christianscarlett/mazernnr/FP.cydsn/codegentemp/ADC_SAR_1.c

/*******************************************************************************
* File Name: ADC_SAR_1.c
* Version 3.0
*
* Description:
*  This file provides the source code to the API for the Successive
*  approximation ADC Component.
*
* Note:
*
********************************************************************************
* Copyright 2008-2015, Cypress Semiconductor Corporation.  All rights reserved.
* You may use this file only in accordance with the license, terms, conditions,
* disclaimers, and limitations in the end user license agreement accompanying
* the software package with which this file was provided.
*******************************************************************************/

#include "CyLib.h"
#include "ADC_SAR_1.h"

#if(ADC_SAR_1_DEFAULT_INTERNAL_CLK)
    #include "ADC_SAR_1_theACLK.h"
#endif /* End ADC_SAR_1_DEFAULT_INTERNAL_CLK */


/***************************************
* Forward function references
***************************************/
static void ADC_SAR_1_CalcGain(uint8 resolution);


/***************************************
* Global data allocation
***************************************/
uint8 ADC_SAR_1_initVar = 0u;
volatile int16 ADC_SAR_1_offset;
volatile int16 ADC_SAR_1_countsPerVolt;     /* Obsolete Gain compensation */
volatile int32 ADC_SAR_1_countsPer10Volt;   /* Gain compensation */
volatile int16 ADC_SAR_1_shift;


/*******************************************************************************
* Function Name: ADC_SAR_1_Start
********************************************************************************
*
* Summary:
*  This is the preferred method to begin component operation.
*  ADC_SAR_1_Start() sets the initVar variable, calls the
*  ADC_SAR_1_Init() function, and then calls the
*  ADC_SAR_1_Enable() function.
*
* Parameters:
*  None.
*
* Return:
*  None.
*
* Global variables:
*  The ADC_SAR_1_initVar variable is used to indicate when/if initial
*  configuration of this component has happened. The variable is initialized to
*  zero and set to 1 the first time ADC_Start() is called. This allows for
*  component Re-Start without re-initialization in all subsequent calls to the
*  ADC_SAR_1_Start() routine.
*  If re-initialization of the component is required the variable should be set
*  to zero before call of ADC_SAR_1_Start() routine, or the user may call
*  ADC_SAR_1_Init() and ADC_SAR_1_Enable() as done in the
*  ADC_SAR_1_Start() routine.
*
* Side Effect:
*  If the initVar variable is already set, this function only calls the
*  ADC_SAR_1_Enable() function.
*
*******************************************************************************/
void ADC_SAR_1_Start(void)
{

    /* If not Initialized then initialize all required hardware and software */
    if(ADC_SAR_1_initVar == 0u)
    {
        ADC_SAR_1_Init();
        ADC_SAR_1_initVar = 1u;
    }
    ADC_SAR_1_Enable();
}


/*******************************************************************************
* Function Name: ADC_SAR_1_Init
********************************************************************************
*
* Summary:
*  Initialize component's parameters to the parameters set by user in the
*  customizer of the component placed onto schematic. Usually called in
*  ADC_SAR_1_Start().
*
* Parameters:
*  None.
*
* Return:
*  None.
*
* Global variables:
*  The ADC_SAR_1_offset variable is initialized to 0.
*
*******************************************************************************/
void ADC_SAR_1_Init(void)
{

    /* This is only valid if there is an internal clock */
    #if(ADC_SAR_1_DEFAULT_INTERNAL_CLK)
        ADC_SAR_1_theACLK_SetMode(CYCLK_DUTY);
    #endif /* End ADC_SAR_1_DEFAULT_INTERNAL_CLK */

    #if(ADC_SAR_1_IRQ_REMOVE == 0u)
        /* Start and set interrupt vector */
        CyIntSetPriority(ADC_SAR_1_INTC_NUMBER, ADC_SAR_1_INTC_PRIOR_NUMBER);
        (void)CyIntSetVector(ADC_SAR_1_INTC_NUMBER, &ADC_SAR_1_ISR);
    #endif   /* End ADC_SAR_1_IRQ_REMOVE */

    /* Enable IRQ mode*/
    ADC_SAR_1_SAR_CSR1_REG |= ADC_SAR_1_SAR_IRQ_MASK_EN | ADC_SAR_1_SAR_IRQ_MODE_EDGE;

    /*Set SAR ADC resolution ADC */
    ADC_SAR_1_SetResolution(ADC_SAR_1_DEFAULT_RESOLUTION);
    ADC_SAR_1_offset = 0;
}


/*******************************************************************************
* Function Name: ADC_SAR_1_Enable
********************************************************************************
*
* Summary:
*  Enables the reference, clock and power for SAR ADC.
*
* Parameters:
*  None.
*
* Return:
*  None.
*
*******************************************************************************/
void ADC_SAR_1_Enable(void)
{
    uint8 tmpReg;
    uint8 enableInterrupts;
    enableInterrupts = CyEnterCriticalSection();

    /* Enable the SAR ADC block in Active Power Mode */
    ADC_SAR_1_PWRMGR_SAR_REG |= ADC_SAR_1_ACT_PWR_SAR_EN;

     /* Enable the SAR ADC in Standby Power Mode*/
    ADC_SAR_1_STBY_PWRMGR_SAR_REG |= ADC_SAR_1_STBY_PWR_SAR_EN;

    /* This is only valid if there is an internal clock */
    #if(ADC_SAR_1_DEFAULT_INTERNAL_CLK)
        ADC_SAR_1_PWRMGR_CLK_REG |= ADC_SAR_1_ACT_PWR_CLK_EN;
        ADC_SAR_1_STBY_PWRMGR_CLK_REG |= ADC_SAR_1_STBY_PWR_CLK_EN;
    #endif /* End ADC_SAR_1_DEFAULT_INTERNAL_CLK */

    /* Enable VCM buffer and Enable Int Ref Amp */
    tmpReg = ADC_SAR_1_SAR_CSR3_REG;
    tmpReg |= ADC_SAR_1_SAR_EN_BUF_VCM_EN;
    /* PD_BUF_VREF is OFF in External reference or Vdda reference mode */
    #if((ADC_SAR_1_DEFAULT_REFERENCE == ADC_SAR_1__EXT_REF) || \
        (ADC_SAR_1_DEFAULT_RANGE == ADC_SAR_1__VNEG_VDDA_DIFF))
        tmpReg &= (uint8)~ADC_SAR_1_SAR_EN_BUF_VREF_EN;
    #else /* In INTREF or INTREF Bypassed this buffer is ON */
        tmpReg |= ADC_SAR_1_SAR_EN_BUF_VREF_EN;
    #endif /* ADC_SAR_1_DEFAULT_REFERENCE == ADC_SAR_1__EXT_REF */
    ADC_SAR_1_SAR_CSR3_REG = tmpReg;

    /* Set reference for ADC */
    #if(ADC_SAR_1_DEFAULT_RANGE == ADC_SAR_1__VNEG_VDDA_DIFF)
        #if(ADC_SAR_1_DEFAULT_REFERENCE == ADC_SAR_1__EXT_REF)
            ADC_SAR_1_SAR_CSR6_REG = ADC_SAR_1_INT_BYPASS_EXT_VREF; /* S2 */
        #else /* Internal Vdda reference or obsolete bypass mode */
            ADC_SAR_1_SAR_CSR6_REG = ADC_SAR_1_VDDA_VREF;           /* S7 */
        #endif /* ADC_SAR_1_DEFAULT_REFERENCE == ADC_SAR_1__EXT_REF */
    #else  /* Reference goes through internal buffer */
        #if(ADC_SAR_1_DEFAULT_REFERENCE == ADC_SAR_1__INT_REF_NOT_BYPASSED)
            ADC_SAR_1_SAR_CSR6_REG = ADC_SAR_1_INT_VREF;            /* S3 + S4 */
        #else /* INTREF Bypassed of External */
            ADC_SAR_1_SAR_CSR6_REG = ADC_SAR_1_INT_BYPASS_EXT_VREF; /* S2 */
        #endif /* ADC_SAR_1_DEFAULT_REFERENCE == ADC_SAR_1__INT_REF_NOT_BYPASSED */
    #endif /* VNEG_VDDA_DIFF */

    /* Low non-overlap delay for sampling clock signals (for 1MSPS) */
    #if(ADC_SAR_1_HIGH_POWER_PULSE == 0u) /* MinPulseWidth <= 50 ns */
        ADC_SAR_1_SAR_CSR5_REG &= (uint8)~ADC_SAR_1_SAR_DLY_INC;
    #else /* Set High non-overlap delay for sampling clock signals (for <500KSPS)*/
        ADC_SAR_1_SAR_CSR5_REG |= ADC_SAR_1_SAR_DLY_INC;
    #endif /* ADC_SAR_1_HIGH_POWER_PULSE == 0u */

    /* Increase comparator latch enable delay by 20%, 
    *  Increase comparator bias current by 30% without impacting delaysDelay 
    *  Default for 1MSPS) 
    */
    #if(ADC_SAR_1_HIGH_POWER_PULSE == 0u)    /* MinPulseWidth <= 50 ns */
        ADC_SAR_1_SAR_CSR5_REG |= ADC_SAR_1_SAR_SEL_CSEL_DFT_CHAR;
    #else /* for <500ksps */
        ADC_SAR_1_SAR_CSR5_REG &= (uint8)~ADC_SAR_1_SAR_SEL_CSEL_DFT_CHAR;
    #endif /* ADC_SAR_1_HIGH_POWER_PULSE == 0u */

    /* Set default power and other configurations for control register 0 in multiple lines */
    ADC_SAR_1_SAR_CSR0_REG = (uint8)((uint8)ADC_SAR_1_DEFAULT_POWER << ADC_SAR_1_SAR_POWER_SHIFT)
    /* SAR_HIZ_CLEAR:   Should not be used for LP */
    #if ((CY_PSOC5LP) || (ADC_SAR_1_DEFAULT_REFERENCE != ADC_SAR_1__EXT_REF))
        | ADC_SAR_1_SAR_HIZ_CLEAR
    #endif /* SAR_HIZ_CLEAR */
    /*Set Convertion mode */
    #if(ADC_SAR_1_DEFAULT_CONV_MODE != ADC_SAR_1__FREE_RUNNING)      /* If triggered mode */
        | ADC_SAR_1_SAR_MX_SOF_UDB           /* source: UDB */
        | ADC_SAR_1_SAR_SOF_MODE_EDGE        /* Set edge-sensitive sof source */
    #endif /* ADC_SAR_1_DEFAULT_CONV_MODE */
    ; /* end of multiple line initialization */

    ADC_SAR_1_SAR_TR0_REG = ADC_SAR_1_SAR_CAP_TRIM_2;

    /* Enable clock for SAR ADC*/
    ADC_SAR_1_SAR_CLK_REG |= ADC_SAR_1_SAR_MX_CLK_EN;

    CyDelayUs(10u); /* The block is ready to use 10 us after the enable signal is set high. */

    #if(ADC_SAR_1_IRQ_REMOVE == 0u)
        /* Clear a pending interrupt */
        CyIntClearPending(ADC_SAR_1_INTC_NUMBER);
    #endif   /* End ADC_SAR_1_IRQ_REMOVE */

    CyExitCriticalSection(enableInterrupts);
}


/*******************************************************************************
* Function Name: ADC_SAR_1_Stop
********************************************************************************
*
* Summary:
*  Stops ADC conversions and puts the ADC into its lowest power mode.
*
* Parameters:
*  None.
*
* Return:
*  None.
*
*******************************************************************************/
void ADC_SAR_1_Stop(void)
{
    uint8 enableInterrupts;
    enableInterrupts = CyEnterCriticalSection();

    /* Stop all conversions */
    ADC_SAR_1_SAR_CSR0_REG &= (uint8)~ADC_SAR_1_SAR_SOF_START_CONV;
    /* Disable the SAR ADC block in Active Power Mode */
    ADC_SAR_1_PWRMGR_SAR_REG &= (uint8)~ADC_SAR_1_ACT_PWR_SAR_EN;
    /* Disable the SAR ADC in Standby Power Mode */
    ADC_SAR_1_STBY_PWRMGR_SAR_REG &= (uint8)~ADC_SAR_1_STBY_PWR_SAR_EN;

    /* This is only valid if there is an internal clock */
    #if(ADC_SAR_1_DEFAULT_INTERNAL_CLK)
        ADC_SAR_1_PWRMGR_CLK_REG &= (uint8)~ADC_SAR_1_ACT_PWR_CLK_EN;
        ADC_SAR_1_STBY_PWRMGR_CLK_REG &= (uint8)~ADC_SAR_1_STBY_PWR_CLK_EN;
    #endif /* End ADC_SAR_1_DEFAULT_INTERNAL_CLK */

    CyExitCriticalSection(enableInterrupts);

}


/*******************************************************************************
* Function Name: ADC_SAR_1_SetPower
********************************************************************************
*
* Summary:
*  Sets the operational power of the ADC. You should use the higher power
*  settings with faster clock speeds.
*
* Parameters:
*  power:  Power setting for ADC
*  0 ->    Normal
*  1 ->    Medium power
*  2 ->    1.25 power
*  3 ->    Minimum power.
*
* Return:
*  None.
*
*******************************************************************************/
void ADC_SAR_1_SetPower(uint8 power)
{
    uint8 tmpReg;

    /* mask off invalid power settings */
    power &= ADC_SAR_1_SAR_API_POWER_MASK;

    /* Set Power parameter  */
    tmpReg = ADC_SAR_1_SAR_CSR0_REG & (uint8)~ADC_SAR_1_SAR_POWER_MASK;
    tmpReg |= (uint8)(power << ADC_SAR_1_SAR_POWER_SHIFT);
    ADC_SAR_1_SAR_CSR0_REG = tmpReg;
}


/*******************************************************************************
* Function Name: ADC_SAR_1_SetResolution
********************************************************************************
*
* Summary:
*  Sets the Relution of the SAR.
*
* Parameters:
*  resolution:
*  12 ->    RES12
*  10 ->    RES10
*  8  ->    RES8
*
* Return:
*  None.
*
* Side Effects:
*  The ADC resolution cannot be changed during a conversion cycle. The
*  recommended best practice is to stop conversions with
*  ADC_StopConvert(), change the resolution, then restart the
*  conversions with ADC_StartConvert().
*  If you decide not to stop conversions before calling this API, you
*  should use ADC_IsEndConversion() to wait until conversion is complete
*  before changing the resolution.
*  If you call ADC_SetResolution() during a conversion, the resolution will
*  not be changed until the current conversion is complete. Data will not be
*  available in the new resolution for another 6 + "New Resolution(in bits)"
*  clock cycles.
*  You may need add a delay of this number of clock cycles after
*  ADC_SetResolution() is called before data is valid again.
*  Affects ADC_CountsTo_Volts(), ADC_CountsTo_mVolts(), and
*  ADC_CountsTo_uVolts() by calculating the correct conversion between ADC
*  counts and the applied input voltage. Calculation depends on resolution,
*  input range, and voltage reference.
*
*******************************************************************************/
void ADC_SAR_1_SetResolution(uint8 resolution)
{
    uint8 tmpReg;

    /* Set SAR ADC resolution and sample width: 18 conversion cycles at 12bits + 1 gap */
    switch (resolution)
    {
        case (uint8)ADC_SAR_1__BITS_12:
            tmpReg = ADC_SAR_1_SAR_RESOLUTION_12BIT | ADC_SAR_1_SAR_SAMPLE_WIDTH;
            break;
        case (uint8)ADC_SAR_1__BITS_10:
            tmpReg = ADC_SAR_1_SAR_RESOLUTION_10BIT | ADC_SAR_1_SAR_SAMPLE_WIDTH;
            break;
        case (uint8)ADC_SAR_1__BITS_8:
            tmpReg = ADC_SAR_1_SAR_RESOLUTION_8BIT | ADC_SAR_1_SAR_SAMPLE_WIDTH;
            break;
        default:
            tmpReg = ADC_SAR_1_SAR_RESOLUTION_12BIT | ADC_SAR_1_SAR_SAMPLE_WIDTH;
            /* Halt CPU in debug mode if resolution is out of valid range */
            CYASSERT(0u != 0u);
            break;
    }
    ADC_SAR_1_SAR_CSR2_REG = tmpReg;

     /* Calculate gain for convert counts to volts */
    ADC_SAR_1_CalcGain(resolution);
}


#if(ADC_SAR_1_DEFAULT_CONV_MODE != ADC_SAR_1__HARDWARE_TRIGGER)


    /*******************************************************************************
    * Function Name: ADC_SAR_1_StartConvert
    ********************************************************************************
    *
    * Summary:
    *  Forces the ADC to initiate a conversion. In free-running mode, the ADC runs
    *  continuously. In software trigger mode, the function also acts as a software
    *  version of the SOC and every conversion must be triggered by
    *  ADC_SAR_1_StartConvert(). This function is not available when the
    *  Hardware Trigger sample mode is selected.
    *
    * Parameters:
    *  None.
    *
    * Return:
    *  None.
    *
    * Theory:
    *  Forces the ADC to initiate a conversion. In Free Running mode, the ADC will
    *  run continuously. In a software trigger mode the function also acts as a
    *  software version of the SOC. Here every conversion has to be triggered by
    *  the routine. This writes into the SOC bit in SAR_CTRL reg.
    *
    * Side Effects:
    *  In a software trigger mode the function switches source for SOF from the
    *  external pin to the internal SOF generation. Application should not call
    *  StartConvert if external source used for SOF.
    *
    *******************************************************************************/
    void ADC_SAR_1_StartConvert(void)
    {
        #if(ADC_SAR_1_DEFAULT_CONV_MODE != ADC_SAR_1__FREE_RUNNING)  /* If software triggered mode */
            ADC_SAR_1_SAR_CSR0_REG &= (uint8)~ADC_SAR_1_SAR_MX_SOF_UDB;   /* source: SOF bit */
        #endif /* End ADC_SAR_1_DEFAULT_CONV_MODE */

        /* Start the conversion */
        ADC_SAR_1_SAR_CSR0_REG |= ADC_SAR_1_SAR_SOF_START_CONV;
    }


    /*******************************************************************************
    * Function Name: ADC_SAR_1_StopConvert
    ********************************************************************************
    *
    * Summary:
    *  Forces the ADC to stop conversions. If a conversion is currently executing,
    *  that conversion will complete, but no further conversions will occur. This
    *  function is not available when the Hardware Trigger sample mode is selected.
    *
    * Parameters:
    *  None.
    *
    * Return:
    *  None.
    *
    * Theory:
    *  Stops ADC conversion in Free Running mode.
    *
    * Side Effects:
    *  In Software Trigger sample mode, this function sets a software version of the
    *  SOC to low level and switches the SOC source to hardware SOC input.
    *
    *******************************************************************************/
    void ADC_SAR_1_StopConvert(void)
    {
        /* Stop all conversions */
        ADC_SAR_1_SAR_CSR0_REG &= (uint8)~ADC_SAR_1_SAR_SOF_START_CONV;

        #if(ADC_SAR_1_DEFAULT_CONV_MODE != ADC_SAR_1__FREE_RUNNING)  /* If software triggered mode */
            /* Return source to UDB for hardware SOF signal */
            ADC_SAR_1_SAR_CSR0_REG |= ADC_SAR_1_SAR_MX_SOF_UDB;    /* source: UDB */
        #endif /* End ADC_SAR_1_DEFAULT_CONV_MODE */

    }

#endif /* End ADC_SAR_1_DEFAULT_CONV_MODE != ADC_SAR_1__HARDWARE_TRIGGER */


/*******************************************************************************
* Function Name: ADC_SAR_1_IsEndConversion
********************************************************************************
*
* Summary:
*  Immediately returns the status of the conversion or does not return
*  (blocking) until the conversion completes, depending on the retMode
*  parameter.
*
* Parameters:
*  retMode:  Check conversion return mode.
*   ADC_SAR_1_RETURN_STATUS: Immediately returns the status. If the
*     value returned is zero, the conversion is not complete, and this function
*     should be retried until a nonzero result is returned.
*   ADC_SAR_1_WAIT_FOR_RESULT: Does not return a result until the ADC
*     conversion is complete.
*
* Return:
*  (uint8)  0 =>  The ADC is still calculating the last result.
*           1 =>  The last conversion is complete.
*
* Side Effects:
*  This function reads the end of conversion status, which is cleared on read.
*
*******************************************************************************/
uint8 ADC_SAR_1_IsEndConversion(uint8 retMode)
{
    uint8 status;

    do
    {
        status = ADC_SAR_1_SAR_CSR1_REG & ADC_SAR_1_SAR_EOF_1;
    } while ((status != ADC_SAR_1_SAR_EOF_1) && (retMode == ADC_SAR_1_WAIT_FOR_RESULT));
    /* If convertion complete, wait until EOF bit released */
    if(status == ADC_SAR_1_SAR_EOF_1)
    {
        /* wait one ADC clock to let the EOC status bit release */
        CyDelayUs(1u);
        /* Do the unconditional read operation of the CSR1 register to make sure the EOC bit has been cleared */
        CY_GET_REG8(ADC_SAR_1_SAR_CSR1_PTR);
    }

    return(status);
}


/*******************************************************************************
* Function Name: ADC_SAR_1_GetResult8
********************************************************************************
*
* Summary:
*  Returns the result of an 8-bit conversion. If the resolution is set greater
*  than 8 bits, the function returns the LSB of the result.
*  ADC_SAR_1_IsEndConversion() should be called to verify that the data
*   sample is ready.
*
* Parameters:
*  None.
*
* Return:
*  The LSB of the last ADC conversion.
*
* Global Variables:
*  ADC_SAR_1_shift - used to convert the ADC counts to the 2s
*  compliment form.
*
* Side Effects:
*  Converts the ADC counts to the 2s complement form.
*
*******************************************************************************/
int8 ADC_SAR_1_GetResult8( void )
{
    return( (int8)ADC_SAR_1_SAR_WRK0_REG - (int8)ADC_SAR_1_shift);
}


/*******************************************************************************
* Function Name: ADC_SAR_1_GetResult16
********************************************************************************
*
* Summary:
*  Returns a 16-bit result for a conversion with a result that has a resolution
*  of 8 to 12 bits.
*  ADC_SAR_1_IsEndConversion() should be called to verify that the data
*   sample is ready
*
* Parameters:
*  None.
*
* Return:
*  The 16-bit result of the last ADC conversion
*
* Global Variables:
*  ADC_SAR_1_shift - used to convert the ADC counts to the 2s
*  compliment form.
*
* Side Effects:
*  Converts the ADC counts to the 2s complement form.
*
*******************************************************************************/
int16 ADC_SAR_1_GetResult16( void )
{
    uint16 res;

    res = CY_GET_REG16(ADC_SAR_1_SAR_WRK_PTR);

    return( (int16)res - ADC_SAR_1_shift );
}


/*******************************************************************************
* Function Name: ADC_SAR_1_SetOffset
********************************************************************************
*
* Summary:
*  Sets the ADC offset, which is used by ADC_SAR_1_CountsTo_Volts(),
*  ADC_SAR_1_CountsTo_mVolts(), and ADC_SAR_1_CountsTo_uVolts()
*  to subtract the offset from the given reading before calculating the voltage
*  conversion.
*
* Parameters:
*  int16: This value is measured when the inputs are shorted or connected to
   the same input voltage.
*
* Return:
*  None.
*
* Global Variables:
*  The ADC_SAR_1_offset variable modified. This variable is used for
*  offset calibration purpose.
*  Affects the ADC_SAR_1_CountsTo_Volts,
*  ADC_SAR_1_CountsTo_mVolts, ADC_SAR_1_CountsTo_uVolts functions
*  by subtracting the given offset.
*
*******************************************************************************/
void ADC_SAR_1_SetOffset(int16 offset)
{
    ADC_SAR_1_offset = offset;
}


/*******************************************************************************
* Function Name: ADC_SAR_1_CalcGain
********************************************************************************
*
* Summary:
*  This function calculates the ADC gain in counts per 10 volt.
*
* Parameters:
*  uint8: resolution
*
* Return:
*  None.
*
* Global Variables:
*  ADC_SAR_1_shift variable initialized. This variable is used to
*  convert the ADC counts to the 2s compliment form.
*  ADC_SAR_1_countsPer10Volt variable initialized. This variable is used
*  for gain calibration purpose.
*
*******************************************************************************/
static void ADC_SAR_1_CalcGain( uint8 resolution )
{
    int32 counts;
    #if(!((ADC_SAR_1_DEFAULT_RANGE == ADC_SAR_1__VSS_TO_VREF) || \
         (ADC_SAR_1_DEFAULT_RANGE == ADC_SAR_1__VSSA_TO_VDDA) || \
         (ADC_SAR_1_DEFAULT_RANGE == ADC_SAR_1__VSSA_TO_VDAC)) )
        uint16 diff_zero;
    #endif /* End ADC_SAR_1_DEFAULT_RANGE */

    switch (resolution)
    {
        case (uint8)ADC_SAR_1__BITS_12:
            counts = (int32)ADC_SAR_1_SAR_WRK_MAX_12BIT;
            #if(!((ADC_SAR_1_DEFAULT_RANGE == ADC_SAR_1__VSS_TO_VREF) || \
                 (ADC_SAR_1_DEFAULT_RANGE == ADC_SAR_1__VSSA_TO_VDDA) || \
                 (ADC_SAR_1_DEFAULT_RANGE == ADC_SAR_1__VSSA_TO_VDAC)) )
                diff_zero = ADC_SAR_1_SAR_DIFF_SHIFT;
            #endif /* End ADC_SAR_1_DEFAULT_RANGE */
            break;
        case (uint8)ADC_SAR_1__BITS_10:
            counts = (int32)ADC_SAR_1_SAR_WRK_MAX_10BIT;
            #if(!((ADC_SAR_1_DEFAULT_RANGE == ADC_SAR_1__VSS_TO_VREF) || \
                 (ADC_SAR_1_DEFAULT_RANGE == ADC_SAR_1__VSSA_TO_VDDA) || \
                 (ADC_SAR_1_DEFAULT_RANGE == ADC_SAR_1__VSSA_TO_VDAC)) )
                diff_zero = ADC_SAR_1_SAR_DIFF_SHIFT >> 2u;
            #endif /* End ADC_SAR_1_DEFAULT_RANGE */
            break;
        case (uint8)ADC_SAR_1__BITS_8:
            counts = (int32)ADC_SAR_1_SAR_WRK_MAX_8BIT;
            #if(!((ADC_SAR_1_DEFAULT_RANGE == ADC_SAR_1__VSS_TO_VREF) || \
                 (ADC_SAR_1_DEFAULT_RANGE == ADC_SAR_1__VSSA_TO_VDDA) || \
                 (ADC_SAR_1_DEFAULT_RANGE == ADC_SAR_1__VSSA_TO_VDAC)) )
                diff_zero = ADC_SAR_1_SAR_DIFF_SHIFT >> 4u;
            #endif /* End ADC_SAR_1_DEFAULT_RANGE */
            break;
        default: /* Halt CPU in debug mode if resolution is out of valid range */
            counts = 0;
            #if(!((ADC_SAR_1_DEFAULT_RANGE == ADC_SAR_1__VSS_TO_VREF) || \
                 (ADC_SAR_1_DEFAULT_RANGE == ADC_SAR_1__VSSA_TO_VDDA) || \
                 (ADC_SAR_1_DEFAULT_RANGE == ADC_SAR_1__VSSA_TO_VDAC)) )
                diff_zero = 0u;
            #endif /* End ADC_SAR_1_DEFAULT_RANGE */
            CYASSERT(0u != 0u);
            break;
    }
    ADC_SAR_1_countsPerVolt = 0; /* Clear obsolete variable */
    /* Calculate gain in counts per 10 volts with rounding */
    ADC_SAR_1_countsPer10Volt = (((counts * ADC_SAR_1_10MV_COUNTS) +
                        ADC_SAR_1_DEFAULT_REF_VOLTAGE_MV) / (ADC_SAR_1_DEFAULT_REF_VOLTAGE_MV * 2));

    #if( (ADC_SAR_1_DEFAULT_RANGE == ADC_SAR_1__VSS_TO_VREF) || \
         (ADC_SAR_1_DEFAULT_RANGE == ADC_SAR_1__VSSA_TO_VDDA) || \
         (ADC_SAR_1_DEFAULT_RANGE == ADC_SAR_1__VSSA_TO_VDAC) )
        ADC_SAR_1_shift = 0;
    #else
        ADC_SAR_1_shift = diff_zero;
    #endif /* End ADC_SAR_1_DEFAULT_RANGE */
}


/*******************************************************************************
* Function Name: ADC_SAR_1_SetGain
********************************************************************************
*
* Summary:
*  Sets the ADC gain in counts per volt for the voltage conversion functions
*  that follow. This value is set by default by the reference and input range
*  settings. It should only be used to further calibrate the ADC with a known
*  input or if the ADC is using an external reference.
*
* Parameters:
*  int16 adcGain counts per volt
*
* Return:
*  None.
*
* Global Variables:
*  ADC_SAR_1_countsPer10Volt variable modified. This variable is used
*  for gain calibration purpose.
*
*******************************************************************************/
void ADC_SAR_1_SetGain(int16 adcGain)
{
    ADC_SAR_1_countsPer10Volt = (int32)adcGain * 10;
}


/*******************************************************************************
* Function Name: ADC_SAR_1_SetScaledGain
********************************************************************************
*
* Summary:
*  Sets the ADC gain in counts per 10 volt for the voltage conversion functions
*  that follow. This value is set by default by the reference and input range
*  settings. It should only be used to further calibrate the ADC with a known
*  input or if the ADC is using an external reference.
*
* Parameters:
*  int32 adcGain  counts per 10 volt
*
* Return:
*  None.
*
* Global Variables:
*  ADC_SAR_1_countsPer10Volt variable modified. This variable is used
*  for gain calibration purpose.
*
*******************************************************************************/
void ADC_SAR_1_SetScaledGain(int32 adcGain)
{
    ADC_SAR_1_countsPer10Volt = adcGain;
}


/*******************************************************************************
* Function Name: ADC_SAR_1_CountsTo_mVolts
********************************************************************************
*
* Summary:
*  Converts the ADC output to millivolts as a 16-bit integer.
*
* Parameters:
*  int16 adcCounts:  Result from the ADC conversion
*
* Return:
*  int16 Result in mVolts
*
* Global Variables:
*  ADC_SAR_1_offset variable used.
*  ADC_SAR_1_countsPer10Volt variable used.
*
*******************************************************************************/
int16 ADC_SAR_1_CountsTo_mVolts(int16 adcCounts)
{
    int16 mVolts;
    int32 countsPer10Volt;

    if(ADC_SAR_1_countsPerVolt != 0)
    {   /* Support obsolete method */
        countsPer10Volt = (int32)ADC_SAR_1_countsPerVolt * 10;
    }
    else
    {
        countsPer10Volt = ADC_SAR_1_countsPer10Volt;
    }

    /* Subtract ADC offset */
    adcCounts -= ADC_SAR_1_offset;
    /* Convert to millivolts with rounding */
    mVolts = (int16)( (( (int32)adcCounts * ADC_SAR_1_10MV_COUNTS ) + ( (adcCounts > 0) ?
                       (countsPer10Volt / 2) : (-(countsPer10Volt / 2)) )) / countsPer10Volt);

    return( mVolts );
}


/*******************************************************************************
* Function Name: ADC_SAR_1_CountsTo_uVolts
********************************************************************************
*
* Summary:
*  Converts the ADC output to microvolts as a 32-bit integer.
*
* Parameters:
*  int16 adcCounts: Result from the ADC conversion
*
* Return:
*  int32 Result in micro Volts
*
* Global Variables:
*  ADC_SAR_1_offset variable used.
*  ADC_SAR_1_countsPer10Volt used to convert ADC counts to uVolts.
*
*******************************************************************************/
int32 ADC_SAR_1_CountsTo_uVolts(int16 adcCounts)
{

    int64 uVolts;
    int32 countsPer10Volt;

    if(ADC_SAR_1_countsPerVolt != 0)
    {   /* Support obsolete method */
        countsPer10Volt = (int32)ADC_SAR_1_countsPerVolt * 10;
    }
    else
    {
        countsPer10Volt = ADC_SAR_1_countsPer10Volt;
    }

    /* Subtract ADC offset */
    adcCounts -= ADC_SAR_1_offset;
    /* To convert adcCounts to microVolts it is required to be multiplied
    *  on 10 million and later divide on gain in counts per 10V.
    */
    uVolts = (( (int64)adcCounts * ADC_SAR_1_10UV_COUNTS ) / countsPer10Volt);

    return( uVolts );
}


/*******************************************************************************
* Function Name: ADC_SAR_1_CountsTo_Volts
********************************************************************************
*
* Summary:
*  Converts the ADC output to volts as a floating-point number.
*
* Parameters:
*  int16 adcCounts: Result from the ADC conversion
*
* Return:
*  float Result in Volts
*
* Global Variables:
*  ADC_SAR_1_offset variable used.
*  ADC_SAR_1_countsPer10Volt used to convert ADC counts to Volts.
*
*******************************************************************************/
float32 ADC_SAR_1_CountsTo_Volts(int16 adcCounts)
{
    float32 volts;
    int32 countsPer10Volt;

    if(ADC_SAR_1_countsPerVolt != 0)
    {   /* Support obsolete method */
        countsPer10Volt = (int32)ADC_SAR_1_countsPerVolt * 10;
    }
    else
    {
        countsPer10Volt = ADC_SAR_1_countsPer10Volt;
    }

    /* Subtract ADC offset */
    adcCounts -= ADC_SAR_1_offset;

    volts = ((float32)adcCounts * ADC_SAR_1_10V_COUNTS) / (float32)countsPer10Volt;

    return( volts );
}


/* [] END OF FILE */
