christianscarlett/mazernnr/FP.cydsn/codegentemp/CyFlash.h

/***************************************************************************//**
* \file CyFlash.h
* \version 5.40
*
* \brief Provides the function definitions for the FLASH/EEPROM.
*
* \note Documentation of the API's in this file is located in the System
* Reference Guide provided with PSoC Creator.
*
********************************************************************************
* \copyright
* Copyright 2008-2016, Cypress Semiconductor Corporation.  All rights reserved.
* You may use this file only in accordance with the license, terms, conditions,
* disclaimers, and limitations in the end user license agreement accompanying
* the software package with which this file was provided.
*******************************************************************************/

#if !defined(CY_BOOT_CYFLASH_H)
#define CY_BOOT_CYFLASH_H

#include "cydevice_trm.h"
#include "cytypes.h"
#include "CyLib.h"
#include "CySpc.h"

#define CY_FLASH_DIE_TEMP_DATA_SIZE      (2u)    /* Die temperature data size */

extern uint8 dieTemperature[CY_FLASH_DIE_TEMP_DATA_SIZE];


/***************************************
*    API Constants
***************************************/

#define CY_FLASH_BASE               (CYDEV_FLASH_BASE)
#define CY_FLASH_SIZE               (CYDEV_FLS_SIZE)
#define CY_FLASH_SIZEOF_ARRAY       (CYDEV_FLS_SECTOR_SIZE)
#define CY_FLASH_SIZEOF_ROW         (CYDEV_FLS_ROW_SIZE)
#define CY_FLASH_SIZEOF_ECC_ROW     (CYDEV_ECC_ROW_SIZE)
#define CY_FLASH_NUMBER_ROWS        (CYDEV_FLS_SIZE / CYDEV_FLS_ROW_SIZE)
#define CY_FLASH_NUMBER_ARRAYS      (CYDEV_FLS_SIZE / CYDEV_FLS_SECTOR_SIZE)

#if(CYDEV_ECC_ENABLE == 0)
    #define CY_FLASH_SIZEOF_FULL_ROW     (CY_FLASH_SIZEOF_ROW + CY_FLASH_SIZEOF_ECC_ROW)
#else
    #define CY_FLASH_SIZEOF_FULL_ROW     (CY_FLASH_SIZEOF_ROW)
#endif  /* (CYDEV_ECC_ENABLE == 0) */
#define CY_EEPROM_BASE              (CYDEV_EE_BASE)
#define CY_EEPROM_SIZE              (CYDEV_EE_SIZE)
#define CY_EEPROM_SIZEOF_ARRAY      (CYDEV_EE_SIZE)     /* EEPROM has one array */
#define CY_EEPROM_SIZEOF_ROW        (CYDEV_EEPROM_ROW_SIZE)
#define CY_EEPROM_NUMBER_ROWS       (CYDEV_EE_SIZE / CYDEV_EEPROM_ROW_SIZE)
#define CY_EEPROM_NUMBER_ARRAYS     (CYDEV_EE_SIZE / CY_EEPROM_SIZEOF_ARRAY)
#define CY_EEPROM_NUMBER_SECTORS    (CYDEV_EE_SIZE / CYDEV_EEPROM_SECTOR_SIZE)
#define CY_EEPROM_SIZEOF_SECTOR     (CYDEV_EEPROM_SECTOR_SIZE)

#if !defined(CYDEV_FLS_BASE)
    #define CYDEV_FLS_BASE    CYDEV_FLASH_BASE
#endif  /* !defined(CYDEV_FLS_BASE) */


/***************************************
*     Function Prototypes
***************************************/

/* Flash Functions */
void     CyFlash_Start(void);
void     CyFlash_Stop(void);
cystatus CySetTemp(void);
cystatus CySetFlashEEBuffer(uint8 * buffer);
cystatus CyWriteRowFull(uint8 arrayId, uint16 rowNumber, const uint8 * rowData, uint16 rowSize) \
            ;
cystatus CyWriteRowData(uint8 arrayId, uint16 rowAddress, const uint8 * rowData);

#if ((CYDEV_ECC_ENABLE == 0u) && (CYDEV_CONFIGURATION_ECC == 0u))
    cystatus CyWriteRowConfig(uint8 arrayId, uint16 rowAddress, const uint8 * rowECC) \
            ;
#endif  /* ((CYDEV_ECC_ENABLE == 0u) && (CYDEV_CONFIGURATION_ECC == 0u)) */

void CyFlash_SetWaitCycles(uint8 freq) ;

/* EEPROM Functions */
void CyEEPROM_Start(void) ;
void CyEEPROM_Stop(void) ;

void CyEEPROM_ReadReserve(void) ;
void CyEEPROM_ReadRelease(void) ;


/***************************************
*     Registers
***************************************/
/* Active Power Mode Configuration Register 0 */
#define CY_FLASH_PM_ACT_CFG0_REG             (* (reg8 *) CYREG_PM_ACT_CFG0)
#define CY_FLASH_PM_ACT_CFG0_PTR             (  (reg8 *) CYREG_PM_ACT_CFG0)

/* Alternate Active Power Mode Configuration Register 0 */
#define CY_FLASH_PM_ALTACT_CFG0_REG          (* (reg8 *) CYREG_PM_STBY_CFG0)
#define CY_FLASH_PM_ALTACT_CFG0_PTR          (  (reg8 *) CYREG_PM_STBY_CFG0)

/* Active Power Mode Configuration Register 12 */
#define CY_FLASH_PM_ACT_CFG12_REG            (* (reg8 *) CYREG_PM_ACT_CFG12)
#define CY_FLASH_PM_ACT_CFG12_PTR            (  (reg8 *) CYREG_PM_ACT_CFG12)

/* Alternate Active Power Mode Configuration Register 12 */
#define CY_FLASH_PM_ALTACT_CFG12_REG         (* (reg8 *) CYREG_PM_STBY_CFG12)
#define CY_FLASH_PM_ALTACT_CFG12_PTR         (  (reg8 *) CYREG_PM_STBY_CFG12)

/* Wake count (BUS_CLK cycles) it takes for the Flash and EEPROM to wake up */
#define CY_FLASH_SPC_FM_EE_WAKE_CNT_REG      (* (reg8 *) CYREG_SPC_FM_EE_WAKE_CNT)
#define CY_FLASH_SPC_FM_EE_WAKE_CNT_PTR      (  (reg8 *) CYREG_SPC_FM_EE_WAKE_CNT)

/* Flash macro control register */
#define CY_FLASH_SPC_FM_EE_CR_REG            (* (reg8 *) CYREG_SPC_FM_EE_CR)
#define CY_FLASH_SPC_FM_EE_CR_PTR            (  (reg8 *) CYREG_SPC_FM_EE_CR)


/* Cache Control Register */
#if (CY_PSOC3)

    #define CY_FLASH_CONTROL_REG                (* (reg8 *) CYREG_CACHE_CR )
    #define CY_FLASH_CONTROL_PTR                (  (reg8 *) CYREG_CACHE_CR )

#else

    #define CY_FLASH_CONTROL_REG                (* (reg8 *) CYREG_CACHE_CC_CTL )
    #define CY_FLASH_CONTROL_PTR                (  (reg8 *) CYREG_CACHE_CC_CTL )

#endif  /* (CY_PSOC3) */


/* EEPROM Status & Control Register */
#define CY_FLASH_EE_SCR_REG                     (* (reg8 *) CYREG_SPC_EE_SCR)
#define CY_FLASH_EE_SCR_PTR                     (  (reg8 *) CYREG_SPC_EE_SCR)



/***************************************
*     Register Constants
***************************************/

/* Power Mode Masks */

/* Enable EEPROM */
#define CY_FLASH_PM_ACT_CFG12_EN_EE             (0x10u)
#define CY_FLASH_PM_ALTACT_CFG12_EN_EE          (0x10u)

/* Enable Flash */
#if (CY_PSOC3)
    #define CY_FLASH_PM_ACT_CFG12_EN_FM         (0x01u)
    #define CY_FLASH_PM_ALTACT_CFG12_EN_FM      (0x01u)
#else
    #define CY_FLASH_PM_ACT_CFG12_EN_FM         (0x0Fu)
    #define CY_FLASH_PM_ALTACT_CFG12_EN_FM      (0x0Fu)
#endif  /* (CY_PSOC3) */



/* Frequency Constants */
#if (CY_PSOC3)
    #define CY_FLASH_CACHE_WS_VALUE_MASK        (0xC0u)
    #define CY_FLASH_CACHE_WS_1_VALUE_MASK      (0x40u)
    #define CY_FLASH_CACHE_WS_2_VALUE_MASK      (0x80u)
    #define CY_FLASH_CACHE_WS_3_VALUE_MASK      (0xC0u)

    #define CY_FLASH_CACHE_WS_1_FREQ_MAX        (22u)
    #define CY_FLASH_CACHE_WS_2_FREQ_MAX        (44u)
    #define CY_FLASH_CACHE_WS_3_FREQ_MAX        (67u)
#endif  /* (CY_PSOC3) */

#if (CY_PSOC5)
    #define CY_FLASH_CACHE_WS_VALUE_MASK        (0xE0u)
    #define CY_FLASH_CACHE_WS_1_VALUE_MASK      (0x40u)
    #define CY_FLASH_CACHE_WS_2_VALUE_MASK      (0x80u)
    #define CY_FLASH_CACHE_WS_3_VALUE_MASK      (0xC0u)
    #define CY_FLASH_CACHE_WS_4_VALUE_MASK      (0x00u)
    #define CY_FLASH_CACHE_WS_5_VALUE_MASK      (0x20u)

    #define CY_FLASH_CACHE_WS_1_FREQ_MAX        (16u)
    #define CY_FLASH_CACHE_WS_2_FREQ_MAX        (33u)
    #define CY_FLASH_CACHE_WS_3_FREQ_MAX        (50u)
    #define CY_FLASH_CACHE_WS_4_FREQ_MAX        (67u)
    #define CY_FLASH_CACHE_WS_5_FREQ_MAX        (83u)
#endif  /* (CY_PSOC5) */

#define CY_FLASH_CYCLES_MASK_SHIFT              (0x06u)
#define CY_FLASH_CYCLES_MASK                    ((uint8)(0x03u << (CY_FLASH_CYCLES_MASK_SHIFT)))

#define CY_FLASH_EE_SCR_AHB_EE_REQ              (0x01u)
#define CY_FLASH_EE_SCR_AHB_EE_ACK              (0x02u)


#define CY_FLASH_EE_EE_AWAKE                    (0x20u)

/* 5(us) * BUS_CLK(80 MHz) / granularity(2) */
#define CY_FLASH_SPC_FM_EE_WAKE_CNT_80MHZ       (0xC8u)

/* Enable clk_spc. This also internally enables the 36MHz IMO. */
#define CY_FLASH_PM_ACT_CFG0_EN_CLK_SPC         (0x08u)
#define CY_FLASH_PM_ALTACT_CFG0_EN_CLK_SPC      (0x08u)

/* Default values for getting temperature. */

#define CY_TEMP_NUMBER_OF_SAMPLES               (0x1u)
#define CY_TEMP_TIMER_PERIOD                    (0xFFFu)
#define CY_TEMP_CLK_DIV_SELECT                  (0x4u)
#define CY_TEMP_NUM_SAMPLES                     (1 << (CY_TEMP_NUMBER_OF_SAMPLES))
#define CY_SPC_CLK_PERIOD                       (120u)      /* nS */
#define CY_SYS_ns_PER_TICK                      (1000u)
#define CY_FRM_EXEC_TIME                        (1000u)     /* nS */

#define CY_GET_TEMP_TIME                        ((1 << (CY_TEMP_NUM_SAMPLES + 1)) * \
                                                    (CY_SPC_CLK_PERIOD * CY_TEMP_CLK_DIV_SELECT) * \
                                                    CY_TEMP_TIMER_PERIOD + CY_FRM_EXEC_TIME)

#define CY_TEMP_MAX_WAIT                        ((CY_GET_TEMP_TIME) / CY_SYS_ns_PER_TICK)    /* In system ticks. */


/*******************************************************************************
* Thne following code is OBSOLETE and must not be used starting with cy_boot
* 4.20.
*
* If the obsoleted macro definitions intended for use in the application use the
* following scheme, redefine your own versions of these definitions:
*    #ifdef <OBSOLETED_DEFINE>
*        #undef  <OBSOLETED_DEFINE>
*        #define <OBSOLETED_DEFINE>      (<New Value>)
*    #endif
*
* Note: Redefine obsoleted macro definitions with caution. They might still be
*       used in the application and their modification might lead to unexpected
*       consequences.
*******************************************************************************/
#if (CY_PSOC5)
    #define CY_FLASH_LESSER_OR_EQUAL_16MHz      (0x01u)
    #define CY_FLASH_LESSER_OR_EQUAL_33MHz      (0x02u)
    #define CY_FLASH_LESSER_OR_EQUAL_50MHz      (0x03u)
    #define CY_FLASH_GREATER_51MHz              (0x00u)
#endif  /* (CY_PSOC5) */

#if (CY_PSOC3)
    #define CY_FLASH_LESSER_OR_EQUAL_22MHz      (0x01u)
    #define CY_FLASH_LESSER_OR_EQUAL_44MHz      (0x02u)
    #define CY_FLASH_GREATER_44MHz              (0x03u)
#endif  /* (CY_PSOC3) */

#define CY_FLASH_PM_ACT_EEFLASH_REG         (* (reg8 *) CYREG_PM_ACT_CFG12)
#define CY_FLASH_PM_ACT_EEFLASH_PTR         (  (reg8 *) CYREG_PM_ACT_CFG12)
#define CY_FLASH_PM_ALTACT_EEFLASH_REG      (* (reg8 *) CYREG_PM_STBY_CFG12)
#define CY_FLASH_PM_ALTACT_EEFLASH_PTR      (  (reg8 *) CYREG_PM_STBY_CFG12)
#define CY_FLASH_PM_EE_MASK                 (0x10u)
#define CY_FLASH_PM_FLASH_MASK              (0x01u)

/*******************************************************************************
* The following code is OBSOLETE and must not be used starting with cy_boot 3.0
*******************************************************************************/
#define FLASH_SIZE                  (CY_FLASH_SIZE)
#define FLASH_SIZEOF_SECTOR         (CY_FLASH_SIZEOF_ARRAY)
#define FLASH_NUMBER_ROWS           (CY_FLASH_NUMBER_ROWS)
#define FLASH_NUMBER_SECTORS        (CY_FLASH_NUMBER_ARRAYS)
#define EEPROM_SIZE                 (CY_EEPROM_SIZE)
#define EEPROM_SIZEOF_SECTOR        (CYDEV_EEPROM_SECTOR_SIZE)
#define EEPROM_NUMBER_ROWS          (CY_EEPROM_NUMBER_ROWS)
#define EEPROM_NUMBER_SECTORS       (CY_EEPROM_NUMBER_SECTORS)


/*******************************************************************************
* The following code is OBSOLETE and must not be used starting with cy_boot 3.30
*******************************************************************************/
#define FLASH_CYCLES_PTR            (CY_FLASH_CONTROL_PTR)

#define TEMP_NUMBER_OF_SAMPLES      (CY_TEMP_NUMBER_OF_SAMPLES)
#define TEMP_TIMER_PERIOD           (CY_TEMP_TIMER_PERIOD)
#define TEMP_CLK_DIV_SELECT         (CY_TEMP_CLK_DIV_SELECT)
#define NUM_SAMPLES                 (CY_TEMP_NUM_SAMPLES)
#define SPC_CLK_PERIOD              (CY_SPC_CLK_PERIOD)
#define FRM_EXEC_TIME               (CY_FRM_EXEC_TIME)
#define GET_TEMP_TIME               (CY_GET_TEMP_TIME)
#define TEMP_MAX_WAIT               (CY_TEMP_MAX_WAIT)

#define ECC_ADDR                    (0x80u)


#define PM_ACT_EE_PTR           (CY_FLASH_PM_ACT_EEFLASH_PTR)
#define PM_ACT_FLASH_PTR        (CY_FLASH_PM_ACT_EEFLASH_PTR)

#define PM_STBY_EE_PTR          (CY_FLASH_PM_ALTACT_EEFLASH_PTR)
#define PM_STBY_FLASH_PTR       (CY_FLASH_PM_ALTACT_EEFLASH_PTR)

#define PM_EE_MASK              (CY_FLASH_PM_EE_MASK)
#define PM_FLASH_MASK           (CY_FLASH_PM_FLASH_MASK)

#define FLASH_CYCLES_MASK_SHIFT     (CY_FLASH_CYCLES_MASK_SHIFT)
#define FLASH_CYCLES_MASK           (CY_FLASH_CYCLES_MASK)


#if (CY_PSOC3)

    #define LESSER_OR_EQUAL_22MHz   (CY_FLASH_LESSER_OR_EQUAL_22MHz)
    #define LESSER_OR_EQUAL_44MHz   (CY_FLASH_LESSER_OR_EQUAL_44MHz)
    #define GREATER_44MHz           (CY_FLASH_GREATER_44MHz)

#endif  /* (CY_PSOC3) */

#if (CY_PSOC5)

    #define LESSER_OR_EQUAL_16MHz   (CY_FLASH_LESSER_OR_EQUAL_16MHz)
    #define LESSER_OR_EQUAL_33MHz   (CY_FLASH_LESSER_OR_EQUAL_33MHz)
    #define LESSER_OR_EQUAL_50MHz   (CY_FLASH_LESSER_OR_EQUAL_50MHz)
    #define LESSER_OR_EQUAL_67MHz   (CY_FLASH_LESSER_OR_EQUAL_67MHz)
    #define GREATER_67MHz           (CY_FLASH_GREATER_67MHz)
    #define GREATER_51MHz           (CY_FLASH_GREATER_51MHz)

#endif  /* (CY_PSOC5) */

#define AHUB_EE_REQ_ACK_PTR         (CY_FLASH_EE_SCR_PTR)


#endif  /* (CY_BOOT_CYFLASH_H) */


/* [] END OF FILE */
