christianscarlett/mazernnr/FP.cydsn/codegentemp/GameTimer.c

/*******************************************************************************
* File Name: GameTimer.c
* Version 2.70
*
* Description:
*  The Timer component consists of a 8, 16, 24 or 32-bit timer with
*  a selectable period between 2 and 2^Width - 1.  The timer may free run
*  or be used as a capture timer as well.  The capture can be initiated
*  by a positive or negative edge signal as well as via software.
*  A trigger input can be programmed to enable the timer on rising edge
*  falling edge, either edge or continous run.
*  Interrupts may be generated due to a terminal count condition
*  or a capture event.
*
* Note:
*
********************************************************************************
* Copyright 2008-2014, Cypress Semiconductor Corporation.  All rights reserved.
* You may use this file only in accordance with the license, terms, conditions,
* disclaimers, and limitations in the end user license agreement accompanying
* the software package with which this file was provided.
********************************************************************************/

#include "GameTimer.h"

uint8 GameTimer_initVar = 0u;


/*******************************************************************************
* Function Name: GameTimer_Init
********************************************************************************
*
* Summary:
*  Initialize to the schematic state
*
* Parameters:
*  void
*
* Return:
*  void
*
*******************************************************************************/
void GameTimer_Init(void) 
{
    #if(!GameTimer_UsingFixedFunction)
            /* Interrupt State Backup for Critical Region*/
            uint8 GameTimer_interruptState;
    #endif /* Interrupt state back up for Fixed Function only */

    #if (GameTimer_UsingFixedFunction)
        /* Clear all bits but the enable bit (if it's already set) for Timer operation */
        GameTimer_CONTROL &= GameTimer_CTRL_ENABLE;

        /* Clear the mode bits for continuous run mode */
        #if (CY_PSOC5A)
            GameTimer_CONTROL2 &= ((uint8)(~GameTimer_CTRL_MODE_MASK));
        #endif /* Clear bits in CONTROL2 only in PSOC5A */

        #if (CY_PSOC3 || CY_PSOC5LP)
            GameTimer_CONTROL3 &= ((uint8)(~GameTimer_CTRL_MODE_MASK));
        #endif /* CONTROL3 register exists only in PSoC3 OR PSoC5LP */

        /* Check if One Shot mode is enabled i.e. RunMode !=0*/
        #if (GameTimer_RunModeUsed != 0x0u)
            /* Set 3rd bit of Control register to enable one shot mode */
            GameTimer_CONTROL |= 0x04u;
        #endif /* One Shot enabled only when RunModeUsed is not Continuous*/

        #if (GameTimer_RunModeUsed == 2)
            #if (CY_PSOC5A)
                /* Set last 2 bits of control2 register if one shot(halt on
                interrupt) is enabled*/
                GameTimer_CONTROL2 |= 0x03u;
            #endif /* Set One-Shot Halt on Interrupt bit in CONTROL2 for PSoC5A */

            #if (CY_PSOC3 || CY_PSOC5LP)
                /* Set last 2 bits of control3 register if one shot(halt on
                interrupt) is enabled*/
                GameTimer_CONTROL3 |= 0x03u;
            #endif /* Set One-Shot Halt on Interrupt bit in CONTROL3 for PSoC3 or PSoC5LP */

        #endif /* Remove section if One Shot Halt on Interrupt is not enabled */

        #if (GameTimer_UsingHWEnable != 0)
            #if (CY_PSOC5A)
                /* Set the default Run Mode of the Timer to Continuous */
                GameTimer_CONTROL2 |= GameTimer_CTRL_MODE_PULSEWIDTH;
            #endif /* Set Continuous Run Mode in CONTROL2 for PSoC5A */

            #if (CY_PSOC3 || CY_PSOC5LP)
                /* Clear and Set ROD and COD bits of CFG2 register */
                GameTimer_CONTROL3 &= ((uint8)(~GameTimer_CTRL_RCOD_MASK));
                GameTimer_CONTROL3 |= GameTimer_CTRL_RCOD;

                /* Clear and Enable the HW enable bit in CFG2 register */
                GameTimer_CONTROL3 &= ((uint8)(~GameTimer_CTRL_ENBL_MASK));
                GameTimer_CONTROL3 |= GameTimer_CTRL_ENBL;

                /* Set the default Run Mode of the Timer to Continuous */
                GameTimer_CONTROL3 |= GameTimer_CTRL_MODE_CONTINUOUS;
            #endif /* Set Continuous Run Mode in CONTROL3 for PSoC3ES3 or PSoC5A */

        #endif /* Configure Run Mode with hardware enable */

        /* Clear and Set SYNCTC and SYNCCMP bits of RT1 register */
        GameTimer_RT1 &= ((uint8)(~GameTimer_RT1_MASK));
        GameTimer_RT1 |= GameTimer_SYNC;

        /*Enable DSI Sync all all inputs of the Timer*/
        GameTimer_RT1 &= ((uint8)(~GameTimer_SYNCDSI_MASK));
        GameTimer_RT1 |= GameTimer_SYNCDSI_EN;

        /* Set the IRQ to use the status register interrupts */
        GameTimer_CONTROL2 |= GameTimer_CTRL2_IRQ_SEL;
    #endif /* Configuring registers of fixed function implementation */

    /* Set Initial values from Configuration */
    GameTimer_WritePeriod(GameTimer_INIT_PERIOD);
    GameTimer_WriteCounter(GameTimer_INIT_PERIOD);

    #if (GameTimer_UsingHWCaptureCounter)/* Capture counter is enabled */
        GameTimer_CAPTURE_COUNT_CTRL |= GameTimer_CNTR_ENABLE;
        GameTimer_SetCaptureCount(GameTimer_INIT_CAPTURE_COUNT);
    #endif /* Configure capture counter value */

    #if (!GameTimer_UsingFixedFunction)
        #if (GameTimer_SoftwareCaptureMode)
            GameTimer_SetCaptureMode(GameTimer_INIT_CAPTURE_MODE);
        #endif /* Set Capture Mode for UDB implementation if capture mode is software controlled */

        #if (GameTimer_SoftwareTriggerMode)
            #if (!GameTimer_UDB_CONTROL_REG_REMOVED)
                if (0u == (GameTimer_CONTROL & GameTimer__B_TIMER__TM_SOFTWARE))
                {
                    GameTimer_SetTriggerMode(GameTimer_INIT_TRIGGER_MODE);
                }
            #endif /* (!GameTimer_UDB_CONTROL_REG_REMOVED) */
        #endif /* Set trigger mode for UDB Implementation if trigger mode is software controlled */

        /* CyEnterCriticalRegion and CyExitCriticalRegion are used to mark following region critical*/
        /* Enter Critical Region*/
        GameTimer_interruptState = CyEnterCriticalSection();

        /* Use the interrupt output of the status register for IRQ output */
        GameTimer_STATUS_AUX_CTRL |= GameTimer_STATUS_ACTL_INT_EN_MASK;

        /* Exit Critical Region*/
        CyExitCriticalSection(GameTimer_interruptState);

        #if (GameTimer_EnableTriggerMode)
            GameTimer_EnableTrigger();
        #endif /* Set Trigger enable bit for UDB implementation in the control register*/
		
		
        #if (GameTimer_InterruptOnCaptureCount && !GameTimer_UDB_CONTROL_REG_REMOVED)
            GameTimer_SetInterruptCount(GameTimer_INIT_INT_CAPTURE_COUNT);
        #endif /* Set interrupt count in UDB implementation if interrupt count feature is checked.*/

        GameTimer_ClearFIFO();
    #endif /* Configure additional features of UDB implementation */

    GameTimer_SetInterruptMode(GameTimer_INIT_INTERRUPT_MODE);
}


/*******************************************************************************
* Function Name: GameTimer_Enable
********************************************************************************
*
* Summary:
*  Enable the Timer
*
* Parameters:
*  void
*
* Return:
*  void
*
*******************************************************************************/
void GameTimer_Enable(void) 
{
    /* Globally Enable the Fixed Function Block chosen */
    #if (GameTimer_UsingFixedFunction)
        GameTimer_GLOBAL_ENABLE |= GameTimer_BLOCK_EN_MASK;
        GameTimer_GLOBAL_STBY_ENABLE |= GameTimer_BLOCK_STBY_EN_MASK;
    #endif /* Set Enable bit for enabling Fixed function timer*/

    /* Remove assignment if control register is removed */
    #if (!GameTimer_UDB_CONTROL_REG_REMOVED || GameTimer_UsingFixedFunction)
        GameTimer_CONTROL |= GameTimer_CTRL_ENABLE;
    #endif /* Remove assignment if control register is removed */
}


/*******************************************************************************
* Function Name: GameTimer_Start
********************************************************************************
*
* Summary:
*  The start function initializes the timer with the default values, the
*  enables the timerto begin counting.  It does not enable interrupts,
*  the EnableInt command should be called if interrupt generation is required.
*
* Parameters:
*  void
*
* Return:
*  void
*
* Global variables:
*  GameTimer_initVar: Is modified when this function is called for the
*   first time. Is used to ensure that initialization happens only once.
*
*******************************************************************************/
void GameTimer_Start(void) 
{
    if(GameTimer_initVar == 0u)
    {
        GameTimer_Init();

        GameTimer_initVar = 1u;   /* Clear this bit for Initialization */
    }

    /* Enable the Timer */
    GameTimer_Enable();
}


/*******************************************************************************
* Function Name: GameTimer_Stop
********************************************************************************
*
* Summary:
*  The stop function halts the timer, but does not change any modes or disable
*  interrupts.
*
* Parameters:
*  void
*
* Return:
*  void
*
* Side Effects: If the Enable mode is set to Hardware only then this function
*               has no effect on the operation of the timer.
*
*******************************************************************************/
void GameTimer_Stop(void) 
{
    /* Disable Timer */
    #if(!GameTimer_UDB_CONTROL_REG_REMOVED || GameTimer_UsingFixedFunction)
        GameTimer_CONTROL &= ((uint8)(~GameTimer_CTRL_ENABLE));
    #endif /* Remove assignment if control register is removed */

    /* Globally disable the Fixed Function Block chosen */
    #if (GameTimer_UsingFixedFunction)
        GameTimer_GLOBAL_ENABLE &= ((uint8)(~GameTimer_BLOCK_EN_MASK));
        GameTimer_GLOBAL_STBY_ENABLE &= ((uint8)(~GameTimer_BLOCK_STBY_EN_MASK));
    #endif /* Disable global enable for the Timer Fixed function block to stop the Timer*/
}


/*******************************************************************************
* Function Name: GameTimer_SetInterruptMode
********************************************************************************
*
* Summary:
*  This function selects which of the interrupt inputs may cause an interrupt.
*  The twosources are caputure and terminal.  One, both or neither may
*  be selected.
*
* Parameters:
*  interruptMode:   This parameter is used to enable interrups on either/or
*                   terminal count or capture.
*
* Return:
*  void
*
*******************************************************************************/
void GameTimer_SetInterruptMode(uint8 interruptMode) 
{
    GameTimer_STATUS_MASK = interruptMode;
}


/*******************************************************************************
* Function Name: GameTimer_SoftwareCapture
********************************************************************************
*
* Summary:
*  This function forces a capture independent of the capture signal.
*
* Parameters:
*  void
*
* Return:
*  void
*
* Side Effects:
*  An existing hardware capture could be overwritten.
*
*******************************************************************************/
void GameTimer_SoftwareCapture(void) 
{
    /* Generate a software capture by reading the counter register */
    #if(GameTimer_UsingFixedFunction)
        (void)CY_GET_REG16(GameTimer_COUNTER_LSB_PTR);
    #else
        (void)CY_GET_REG8(GameTimer_COUNTER_LSB_PTR_8BIT);
    #endif/* (GameTimer_UsingFixedFunction) */
    /* Capture Data is now in the FIFO */
}


/*******************************************************************************
* Function Name: GameTimer_ReadStatusRegister
********************************************************************************
*
* Summary:
*  Reads the status register and returns it's state. This function should use
*  defined types for the bit-field information as the bits in this register may
*  be permuteable.
*
* Parameters:
*  void
*
* Return:
*  The contents of the status register
*
* Side Effects:
*  Status register bits may be clear on read.
*
*******************************************************************************/
uint8   GameTimer_ReadStatusRegister(void) 
{
    return (GameTimer_STATUS);
}


#if (!GameTimer_UDB_CONTROL_REG_REMOVED) /* Remove API if control register is unused */


/*******************************************************************************
* Function Name: GameTimer_ReadControlRegister
********************************************************************************
*
* Summary:
*  Reads the control register and returns it's value.
*
* Parameters:
*  void
*
* Return:
*  The contents of the control register
*
*******************************************************************************/
uint8 GameTimer_ReadControlRegister(void) 
{
    #if (!GameTimer_UDB_CONTROL_REG_REMOVED) 
        return ((uint8)GameTimer_CONTROL);
    #else
        return (0);
    #endif /* (!GameTimer_UDB_CONTROL_REG_REMOVED) */
}


/*******************************************************************************
* Function Name: GameTimer_WriteControlRegister
********************************************************************************
*
* Summary:
*  Sets the bit-field of the control register.
*
* Parameters:
*  control: The contents of the control register
*
* Return:
*
*******************************************************************************/
void GameTimer_WriteControlRegister(uint8 control) 
{
    #if (!GameTimer_UDB_CONTROL_REG_REMOVED) 
        GameTimer_CONTROL = control;
    #else
        control = 0u;
    #endif /* (!GameTimer_UDB_CONTROL_REG_REMOVED) */
}

#endif /* Remove API if control register is unused */


/*******************************************************************************
* Function Name: GameTimer_ReadPeriod
********************************************************************************
*
* Summary:
*  This function returns the current value of the Period.
*
* Parameters:
*  void
*
* Return:
*  The present value of the counter.
*
*******************************************************************************/
uint32 GameTimer_ReadPeriod(void) 
{
   #if(GameTimer_UsingFixedFunction)
       return ((uint32)CY_GET_REG16(GameTimer_PERIOD_LSB_PTR));
   #else
       return (CY_GET_REG32(GameTimer_PERIOD_LSB_PTR));
   #endif /* (GameTimer_UsingFixedFunction) */
}


/*******************************************************************************
* Function Name: GameTimer_WritePeriod
********************************************************************************
*
* Summary:
*  This function is used to change the period of the counter.  The new period
*  will be loaded the next time terminal count is detected.
*
* Parameters:
*  period: This value may be between 1 and (2^Resolution)-1.  A value of 0 will
*          result in the counter remaining at zero.
*
* Return:
*  void
*
*******************************************************************************/
void GameTimer_WritePeriod(uint32 period) 
{
    #if(GameTimer_UsingFixedFunction)
        uint16 period_temp = (uint16)period;
        CY_SET_REG16(GameTimer_PERIOD_LSB_PTR, period_temp);
    #else
        CY_SET_REG32(GameTimer_PERIOD_LSB_PTR, period);
    #endif /*Write Period value with appropriate resolution suffix depending on UDB or fixed function implementation */
}


/*******************************************************************************
* Function Name: GameTimer_ReadCapture
********************************************************************************
*
* Summary:
*  This function returns the last value captured.
*
* Parameters:
*  void
*
* Return:
*  Present Capture value.
*
*******************************************************************************/
uint32 GameTimer_ReadCapture(void) 
{
   #if(GameTimer_UsingFixedFunction)
       return ((uint32)CY_GET_REG16(GameTimer_CAPTURE_LSB_PTR));
   #else
       return (CY_GET_REG32(GameTimer_CAPTURE_LSB_PTR));
   #endif /* (GameTimer_UsingFixedFunction) */
}


/*******************************************************************************
* Function Name: GameTimer_WriteCounter
********************************************************************************
*
* Summary:
*  This funtion is used to set the counter to a specific value
*
* Parameters:
*  counter:  New counter value.
*
* Return:
*  void
*
*******************************************************************************/
void GameTimer_WriteCounter(uint32 counter) 
{
   #if(GameTimer_UsingFixedFunction)
        /* This functionality is removed until a FixedFunction HW update to
         * allow this register to be written
         */
        CY_SET_REG16(GameTimer_COUNTER_LSB_PTR, (uint16)counter);
        
    #else
        CY_SET_REG32(GameTimer_COUNTER_LSB_PTR, counter);
    #endif /* Set Write Counter only for the UDB implementation (Write Counter not available in fixed function Timer */
}
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
